KenWillmott/Mini11-M8E/m8.png

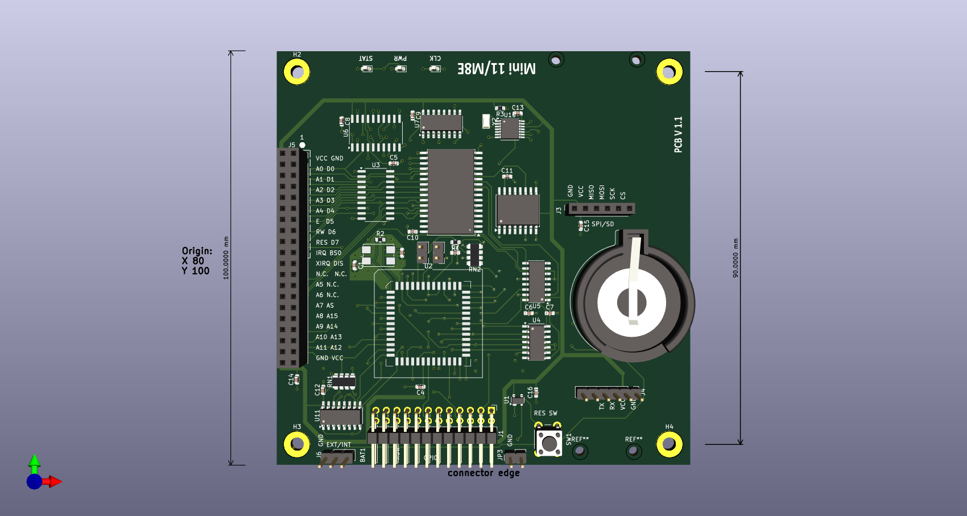
m8.png
