KenWillmott/Mini11-M8E/board.png

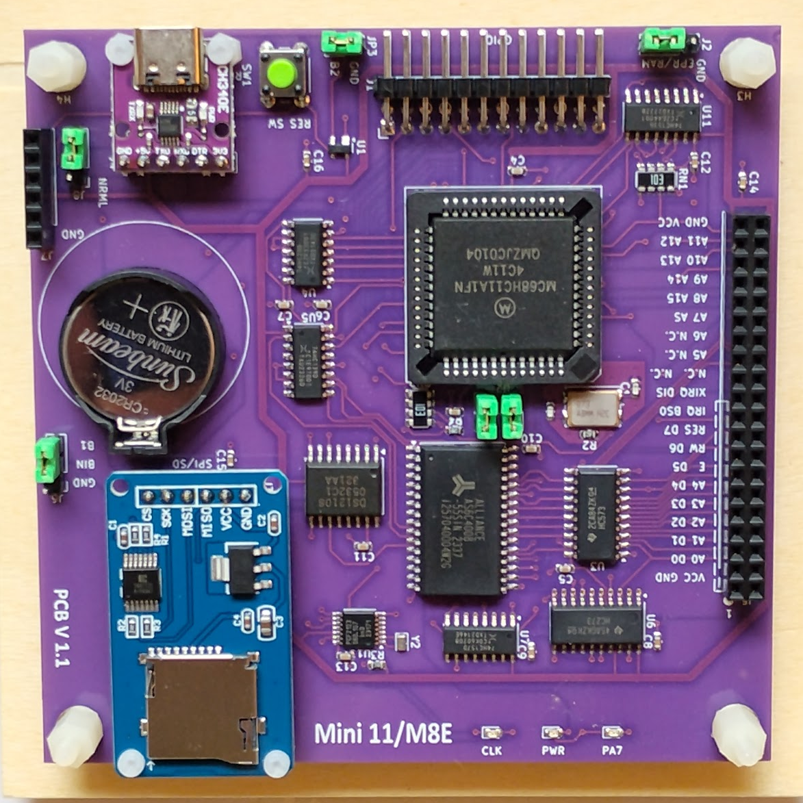
board.png
