KenWillmott/Mini11-M8E/README.md

# Mini11-M8E
MC68HC11A1 MCU based SBC, no ROM
Please read the wiki https://github.com/KenWillmott/Mini11-M8E/wiki
board
