KenWillmott/Mini11-M8E/BOM-T-H27W22492B-2024-09-25.xls

Item # | *Designator | *Qty | Manufacturer | *Mfg Part # | Description / Value | *Package/Footprint | Mounting Type
1 | BT1 | 1 | Keystone |  | CR2032 | Battery:BatteryHolder_Keystone_107_1x23mm | thru-hole
2 | C1,C3 | 2 |  | 0603CG220J500NT | 22p | Capacitor_SMD:C_0603_1608Metric | SMD
3 | C2,C4,C5,C6,C7,C8,C9,C10,C11,C12,C13,C14,C15,C16 | 14 |  | CC0603KRX7R6BB104 | 100n | Capacitor_SMD:C_0603_1608Metric | SMD
4 | D1 | 1 |  | LTST-C191KRKT | STAT | LED_SMD:LED_0603_1608Metric | SMD
5 | D2 | 1 |  | LTST-C191KRKT | PWR | LED_SMD:LED_0603_1608Metric | SMD
6 | D3 | 1 |  | LTST-C191KRKT | CLK | LED_SMD:LED_0603_1608Metric | SMD
7 | H1,H2,H3,H4 | 4 |  |  | MountingHole_Pad | MountingHole:MountingHole_3.2mm_M3_Pad | -
8 | J1 | 1 |  |  | I/O | Connector_PinHeader_2.54mm:PinHeader_2x12_P2.54mm_Horizontal | thru-hole
9 | J2 | 1 |  |  | SBOOT | Connector_PinHeader_2.54mm:PinHeader_1x03_P2.54mm_Vertical | thru-hole
10 | J3 | 1 |  |  | OBSD | Connector_PinHeader_2.54mm:PinHeader_1x06_P2.54mm_Vertical | thru-hole
11 | J4,J7 | 2 |  |  | Serial | -- mixed values -- | thru-hole
12 | J5 | 1 |  |  | Conn_02x20_Odd_Even | Connector_PinSocket_2.54mm:PinSocket_2x20_P2.54mm_Vertical | thru-hole
13 | J6 | 1 |  |  | BAT1 | Connector_PinHeader_2.54mm:PinHeader_1x03_P2.54mm_Vertical | thru-hole
14 | J8 | 1 |  |  | SSEL | Connector_PinHeader_2.54mm:PinHeader_1x03_P2.54mm_Vertical | thru-hole
15 | JP1 | 1 |  |  | MODA | Connector_PinHeader_2.54mm:PinHeader_1x02_P2.54mm_Vertical | thru-hole
16 | JP2 | 1 |  |  | MODB | Connector_PinHeader_2.54mm:PinHeader_1x02_P2.54mm_Vertical | thru-hole
17 | JP3 | 1 |  |  | BAT2 | Connector_PinHeader_2.54mm:PinHeader_1x02_P2.54mm_Vertical | thru-hole
18 | R1 | 1 |  | RC0603FR-071KL | 1.0k | Resistor_SMD:R_0603_1608Metric | SMD
19 | R2 | 1 |  | RC0603FR-0710ML | 10M | Resistor_SMD:R_0603_1608Metric | SMD
20 | R3 | 1 |  | RC0603FR-0710KL | 10k | Resistor_SMD:R_0603_1608Metric | SMD
21 | RN1,RN2 | 2 | Panasonic | YC324-JK-0710KL | R_Pack04 | Resistor_SMD:R_Array_Convex_4x1206 | SMD
22 | SW1 | 1 |  |  | Reset | Button_Switch_THT:SW_PUSH_6mm_H4.3mm | thru-hole
23 | U1 | 1 | Microchip Technology | MIC811LUY-TR | MIC811LUY | Package_TO_SOT_SMD:SOT-143 | SMD
24 | U2 | 1 | 3M | 8452-21B1-RK-TP | 68HC11_PLCC | Package_LCC:PLCC-52_SMD-Socket | SMD
25 | U3 | 1 |  | SN74HC573NSR | 74HC573 | Package_SO:SO-20_5.3x12.6mm_P1.27mm | SMD
26 | U4 | 1 |  | 74HC20D,653 | 74HC20 | Package_SO:SO-14_3.9x8.65mm_P1.27mm | SMD
27 | U5 | 1 |  | 74HC139D,653 | 74HC139 | Package_SO:SO-16_3.9x9.9mm_P1.27mm | SMD
28 | U6 | 1 |  | SN74HC273NSR | 74HC273 | Package_SO:SO-20_5.3x12.6mm_P1.27mm | SMD
29 | U7 | 1 |  | 74HC157D,653 | 74HC157 | Package_SO:SO-16_3.9x9.9mm_P1.27mm | SMD
30 | U8 | 1 |  | AS6C4008-55SIN | AS6C4008 | Package_SO:SSOP-32_11.305x20.495mm_P1.27mm | SMD
31 | U9 | 1 | Maxim, Analog Devices | DS1210S | DS1210S | Package_SO:SOIC-16W_7.5x10.3mm_P1.27mm | SMD
32 | U10 | 1 | NXP | PCF2123TS/1,118 | PCF2123 | Package_SO:TSSOP-14_4.4x5mm_P0.65mm | SMD
33 | U11 | 1 |  | 74HC153D,653 | 74LS153 | Package_SO:SOIC-16_3.9x9.9mm_P1.27mm | SMD
34 | Y1 | 1 | Abracon | ABMM-7.3728MHZ-B2-T | 7.3728 MHz | Crystal:Crystal_SMD_FOX_FQ7050-4Pin_7.0x5.0mm | SMD
35 | Y2 | 1 | Abracon | ABS06-32.768KHZ-T | 32768 kHz | Crystal:Crystal_SMD_2012-2Pin_2.0x1.2mm | SMD
