KenWillmott/Mini11-M8E/m8.pdf

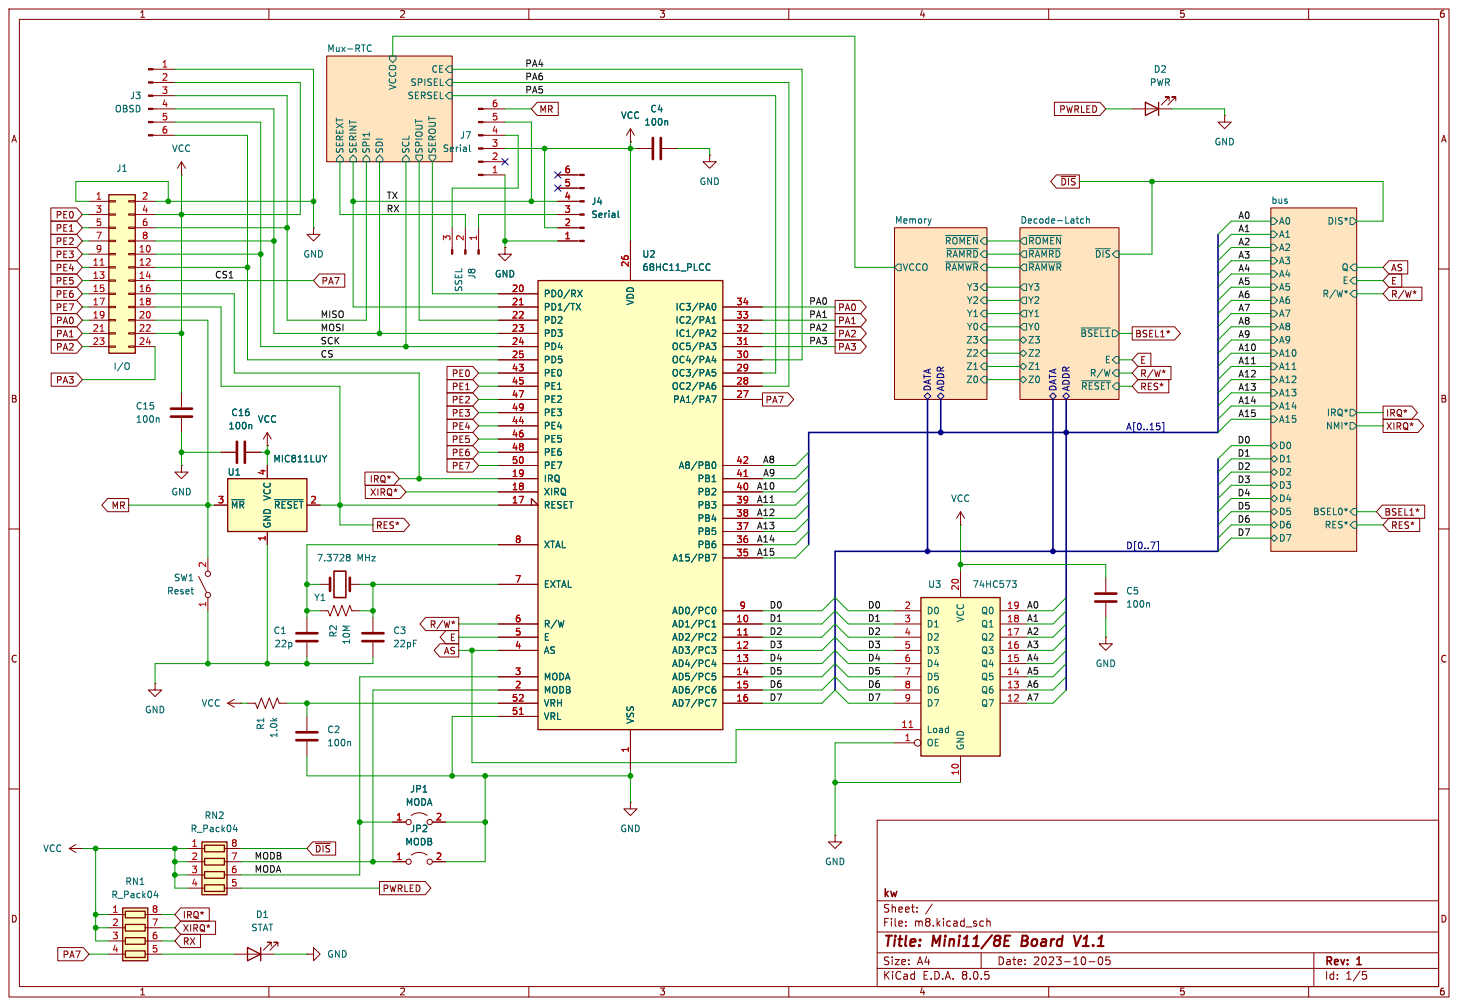
[picture p3: page 1]

IRQ* bus DATA ADDR
Y0Y1Y2 ~{ROMEN}
~{RAMRD}

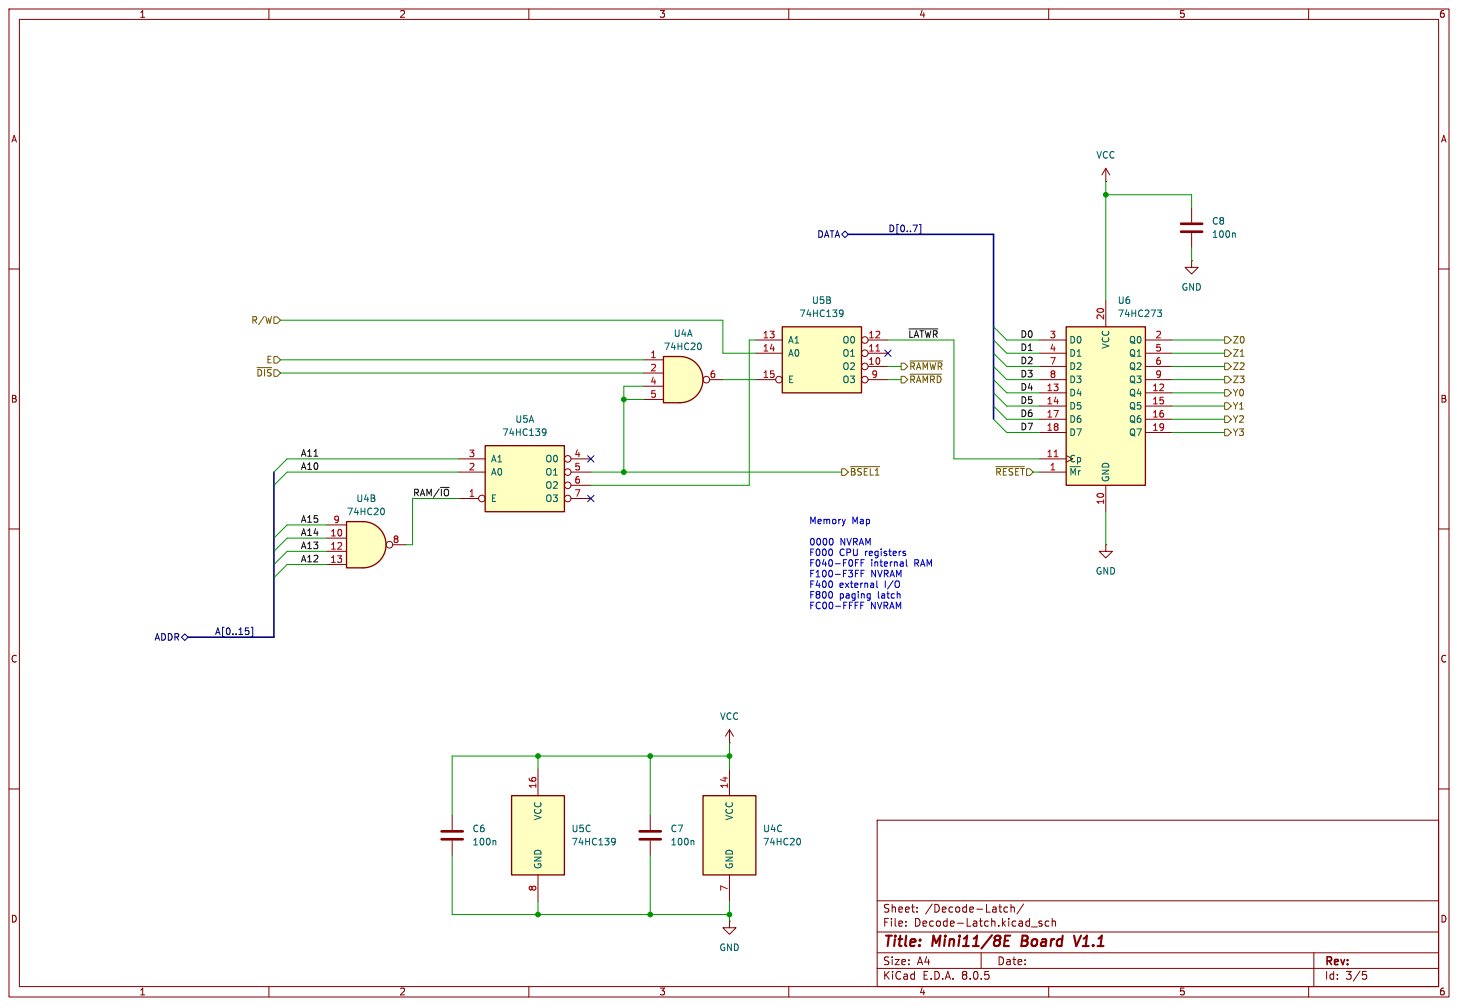
[picture p4: page 2]

File: Decode-Latch.kicad_sch Sheet: /Decode-Latch/

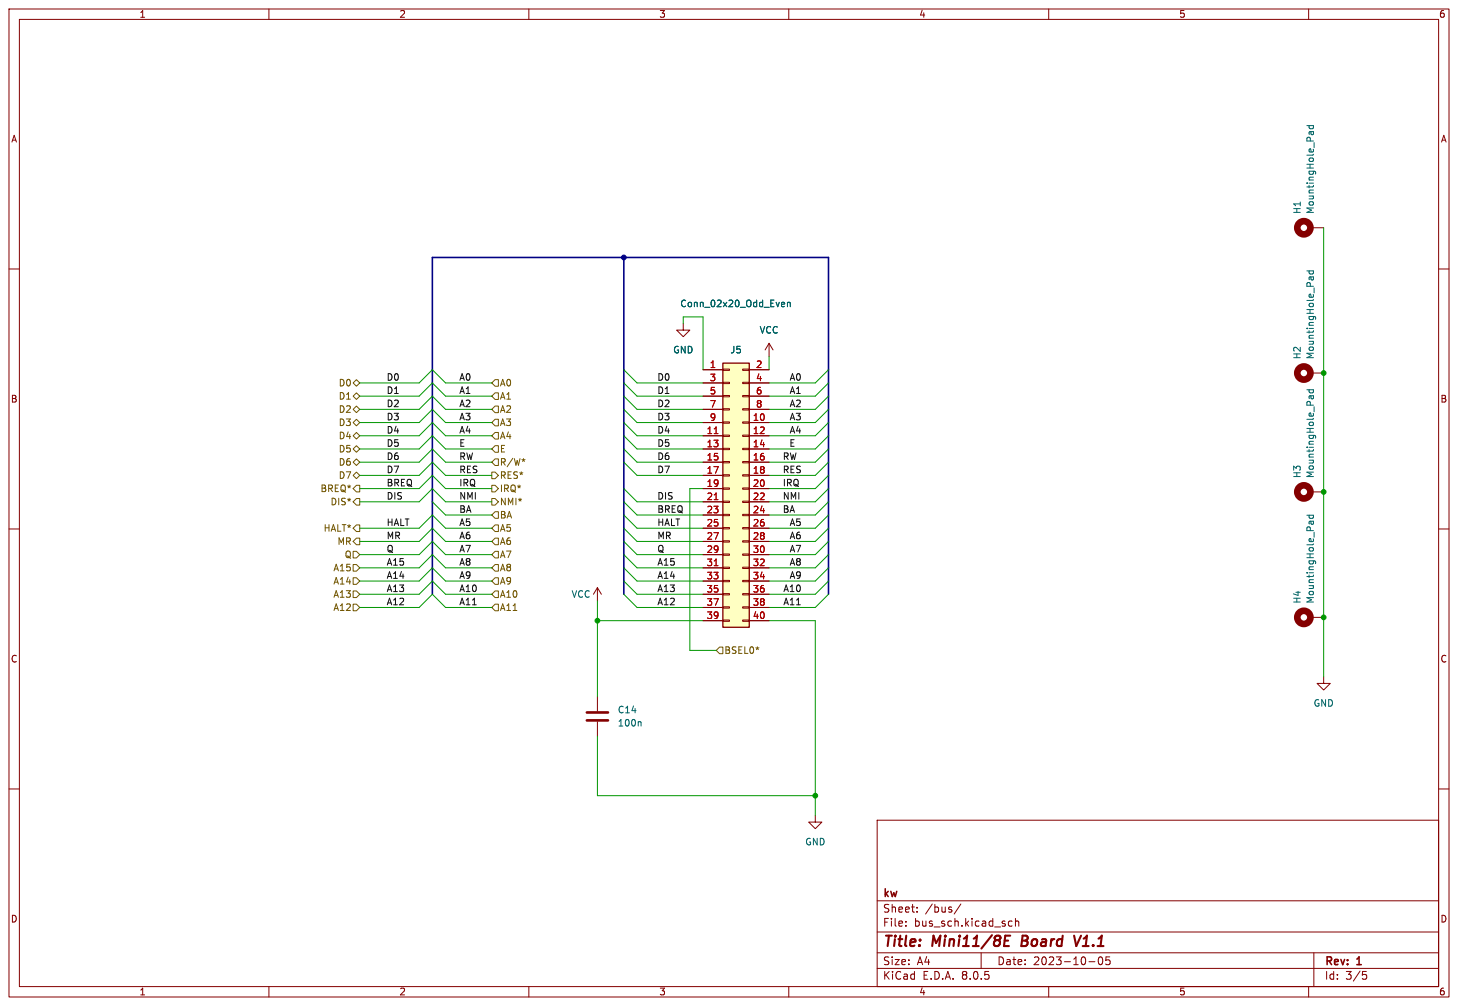
[picture p5: page 3]

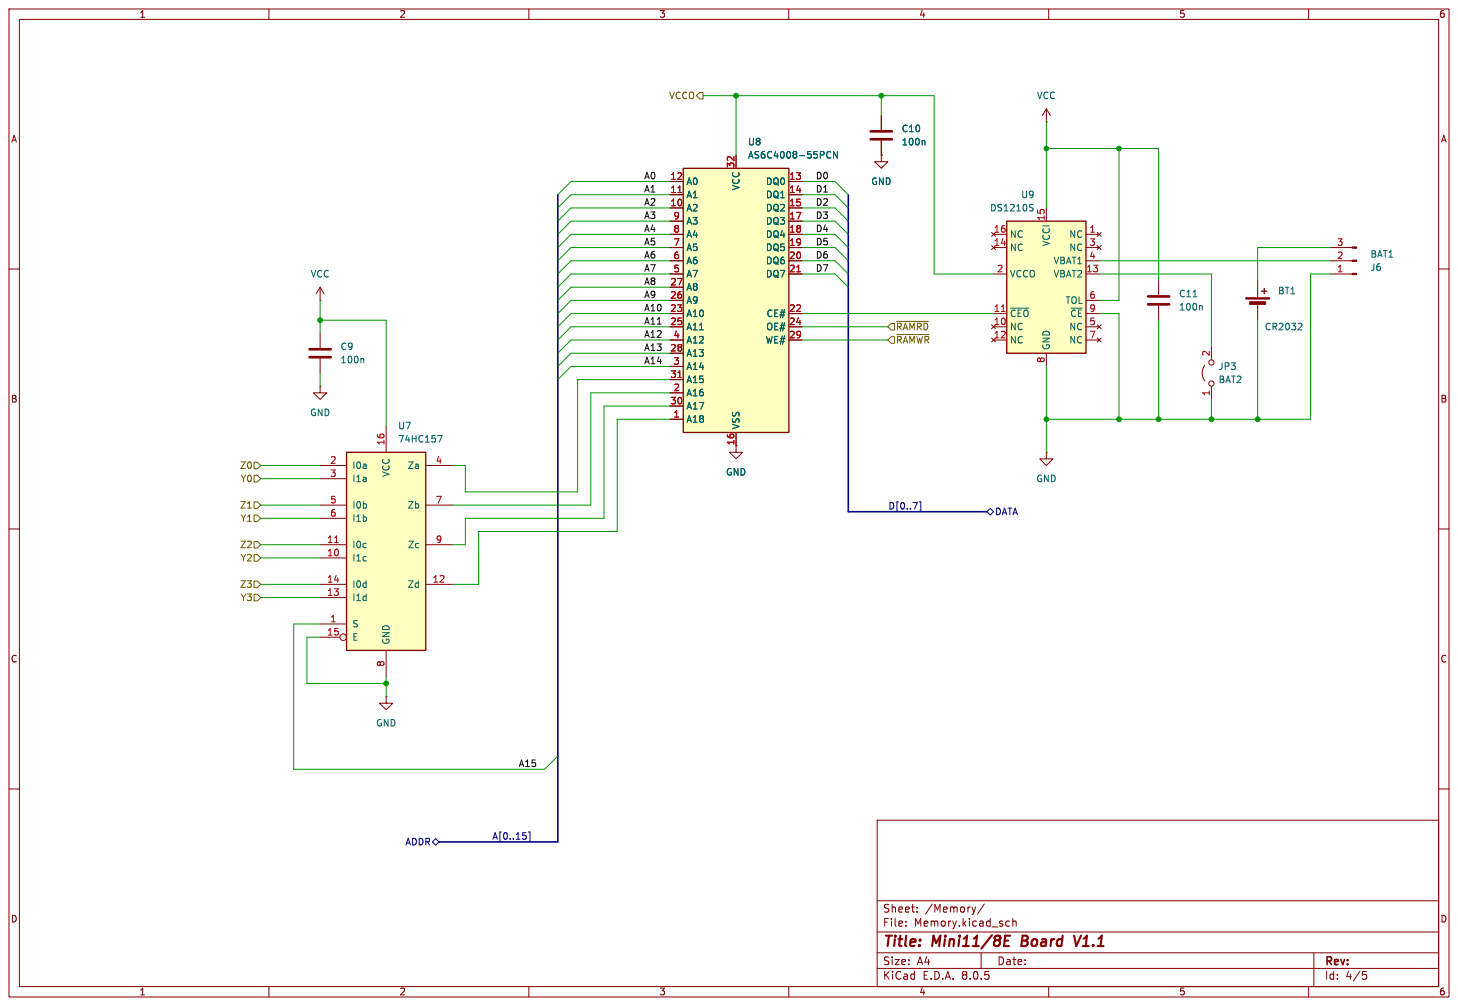
[picture p6: page 4]

File: Memory.kicad_sch Sheet: /Memory/ GND S 1

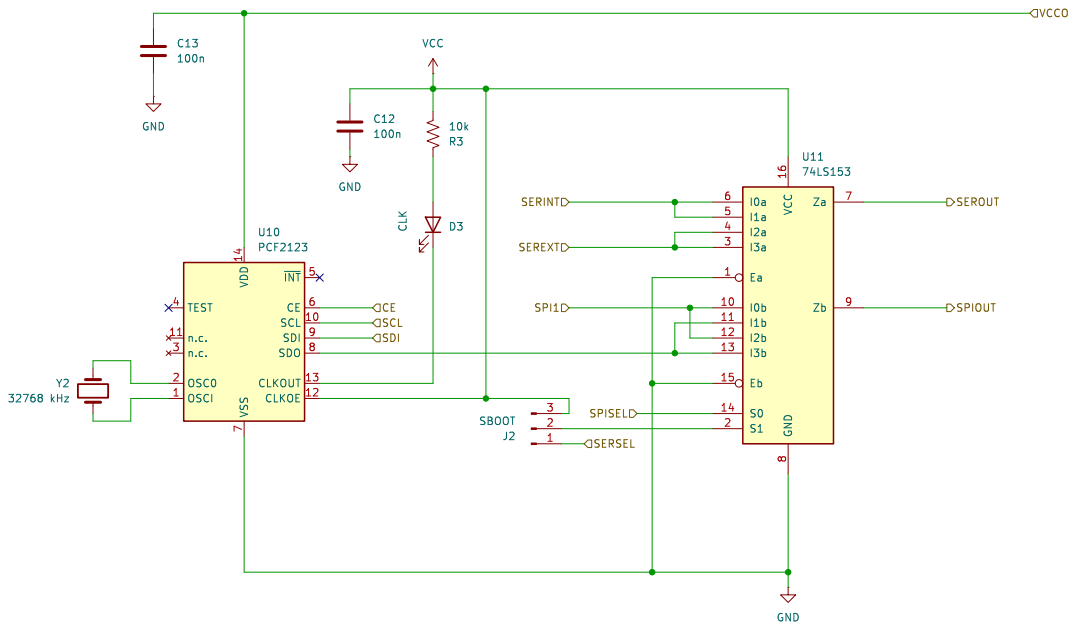
[picture p7: page 5]

File: Mux-RTC_sch.kicad_sch Sheet: /Mux-RTC/
