KenWillmott/Mini11-M8E/m8.kicad_pcb

## KiCad design m8.kicad_pcb (2024-11-02)

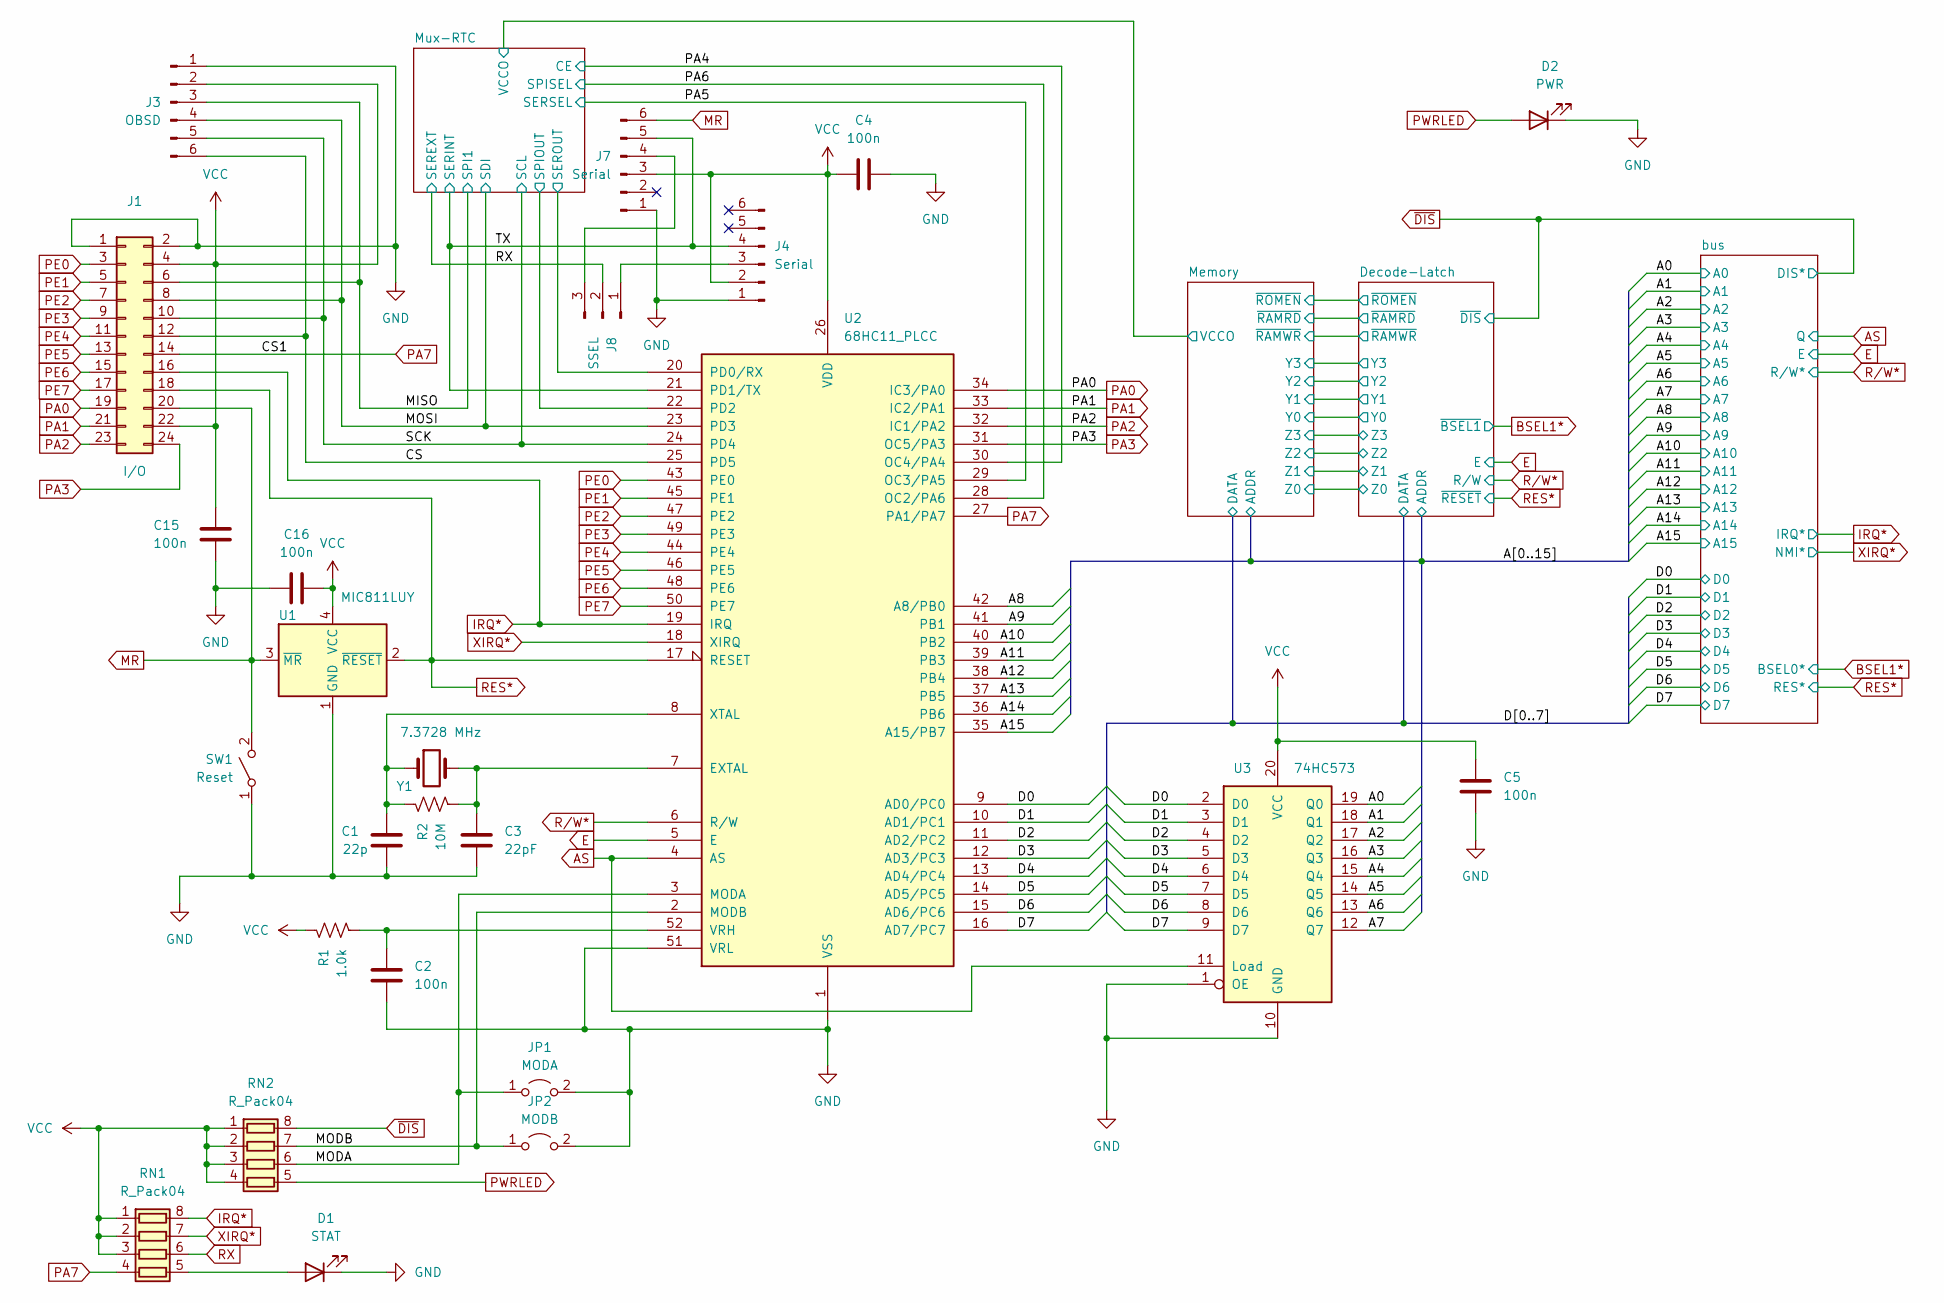
[picture p8: schematic m8.kicad_sch, Mini11/8E Board V1.1]

Parts:
C1: 22p; C_0603_1608Metric
C2, C4, C5, C15, C16: 100n; C_0603_1608Metric
C3: 22pF; C_0603_1608Metric
D1: STAT; LED_0603_1608Metric
D2: PWR; LED_0603_1608Metric
J1: I/O; PinHeader_2x12_P2.54mm_Horizontal
J3: OBSD; PinHeader_1x06_P2.54mm_Vertical
J4: Serial; PinHeader_1x06_P2.54mm_Vertical
J7: Serial; PinSocket_1x06_P2.54mm_Vertical
J8: SSEL; PinHeader_1x03_P2.54mm_Vertical
JP1: MODA; PinHeader_1x02_P2.54mm_Vertical
JP2: MODB; PinHeader_1x02_P2.54mm_Vertical
R1: 1.0k; R_0603_1608Metric
R2: 10M; R_0603_1608Metric
RN1, RN2: R_Pack04; R_Array_Convex_4x1206
SW1: Reset; SW_PUSH_6mm_H4.3mm
U1: MIC811LUY; SOT-143
U2: 68HC11_PLCC; PLCC-52_SMD-Socket
U3: 74HC573; SO-20_12.8x7.5mm_P1.27mm
Y1: 7.3728 MHz; Crystal_SMD_FOX_FQ7050-4Pin_7.0x5.0mm

Connections:
/A0: U3.19 (Q0); also elsewhere on the board
/A1: U3.18 (Q1); also elsewhere on the board
/A2: U3.17 (Q2); also elsewhere on the board
/A3: U3.16 (Q3); also elsewhere on the board
/A4: U3.15 (Q4); also elsewhere on the board
/A5: U3.14 (Q5); also elsewhere on the board
/A6: U3.13 (Q6); also elsewhere on the board
/A7: U3.12 (Q7); also elsewhere on the board
/A8: U2.42 (A8/PB0); also elsewhere on the board
/A9: U2.41 (PB1); also elsewhere on the board
/A10: U2.40 (PB2); also elsewhere on the board
/A11: U2.39 (PB3); also elsewhere on the board
/A12: U2.38 (PB4); also elsewhere on the board
/A13: U2.37 (PB5); also elsewhere on the board
/A14: U2.36 (PB6); also elsewhere on the board
/A15: U2.35 (A15/PB7); also elsewhere on the board
/CS: J1.12, J3.6, U2.25 (PD5)
/D0: U2.9 (AD0/PC0), U3.2 (D0); also elsewhere on the board
/D1: U2.10 (AD1/PC1), U3.3 (D1); also elsewhere on the board
/D2: U2.11 (AD2/PC2), U3.4 (D2); also elsewhere on the board
/D3: U2.12 (AD3/PC3), U3.5 (D3); also elsewhere on the board
/D4: U2.13 (AD4/PC4), U3.6 (D4); also elsewhere on the board
/D5: U2.14 (AD5/PC5), U3.7 (D5); also elsewhere on the board
/D6: U2.15 (AD6/PC6), U3.8 (D6); also elsewhere on the board
/D7: U2.16 (AD7/PC7), U3.9 (D7); also elsewhere on the board
/MISO: J1.6, J3.3; also elsewhere on the board
/MODA: JP1.1 (A), RN2.6 (R3.2), U2.3 (MODA)
/MODB: JP2.1 (A), RN2.7 (R2.2), U2.2 (MODB)
/MOSI: J1.8, J3.4, U2.23 (PD3); also elsewhere on the board
/Mux-RTC/SEROUT: U2.20 (PD0/RX); also elsewhere on the board
/Mux-RTC/SPIOUT: U2.22 (PD2); also elsewhere on the board
/PA4: U2.30 (OC4/PA4); also elsewhere on the board
/PA5: U2.29 (OC3/PA5); also elsewhere on the board
/PA6: U2.28 (OC2/PA6); also elsewhere on the board
/SCK: J1.10, J3.5, U2.24 (PD4); also elsewhere on the board
/TX: J4.4, J7.5, U2.21 (PD1/TX); also elsewhere on the board
AS: U2.4 (AS), U3.11 (Load); also elsewhere on the board
E: U2.5 (E); also elsewhere on the board
GND: C1.2, C2.2, C3.2, C4.2, C5.2, C15.2, C16.1, D1.1 (K), D2.1 (K), J1.1, J1.2, J3.1, J4.1, J7.1, JP1.2 (B), JP2.2 (B), SW1.1 (A), U1.1 (GND), U2.1 (VSS), U2.51 (VRL), U3.1 (OE), U3.10 (GND); also elsewhere on the board
IRQ*: J1.16, RN1.8 (R1.2), U2.19 (IRQ); also elsewhere on the board
MR: J1.20, J7.6, SW1.2 (B), U1.3 (~MR)
unnamed: D1.2 (A), RN1.5 (R4.2)
unnamed: J4.3, J8.1
unnamed: J7.4, J8.3
unnamed: C3.1, R2.2, U2.7 (EXTAL), Y1.3
unnamed: C2.1, R1.2, U2.52 (VRH)
unnamed: C1.1, R2.1, U2.8 (XTAL), Y1.1
PA0: J1.19, U2.34 (IC3/PA0)
PA1: J1.21, U2.33 (IC2/PA1)
PA2: J1.23, U2.32 (IC1/PA2)
PA3: J1.24, U2.31 (OC5/PA3)
PA7: J1.14, RN1.4 (R4.1), U2.27 (PA1/PA7)
PE0: J1.3, U2.43 (PE0)
PE1: J1.5, U2.45 (PE1)
PE2: J1.7, U2.47 (PE2)
PE3: J1.9, U2.49 (PE3)
PE4: J1.11, U2.44 (PE4)
PE5: J1.13, U2.46 (PE5)
PE6: J1.15, U2.48 (PE6)
PE7: J1.17, U2.50 (PE7)
PWRLED: D2.2 (A), RN2.5 (R4.2)
RES*: J1.18, U1.2 (~RESET), U2.17 (RESET); also elsewhere on the board
RX: J8.2, RN1.6 (R3.2); also elsewhere on the board
R/W*: U2.6 (R/W); also elsewhere on the board
VCC: C4.1, C5.1, C15.1, C16.2, J1.4, J1.22, J3.2, J4.2, J7.3, R1.1, RN1.1 (R1.1), RN1.2 (R2.1), RN1.3 (R3.1), RN2.1 (R1.1), RN2.2 (R2.1), RN2.3 (R3.1), RN2.4 (R4.1), U1.4 (VCC), U2.26 (VDD), U3.20 (VCC); also elsewhere on the board
XIRQ*: RN1.7 (R2.2), U2.18 (XIRQ); also elsewhere on the board
~DIS: RN2.8 (R1.2); also elsewhere on the board

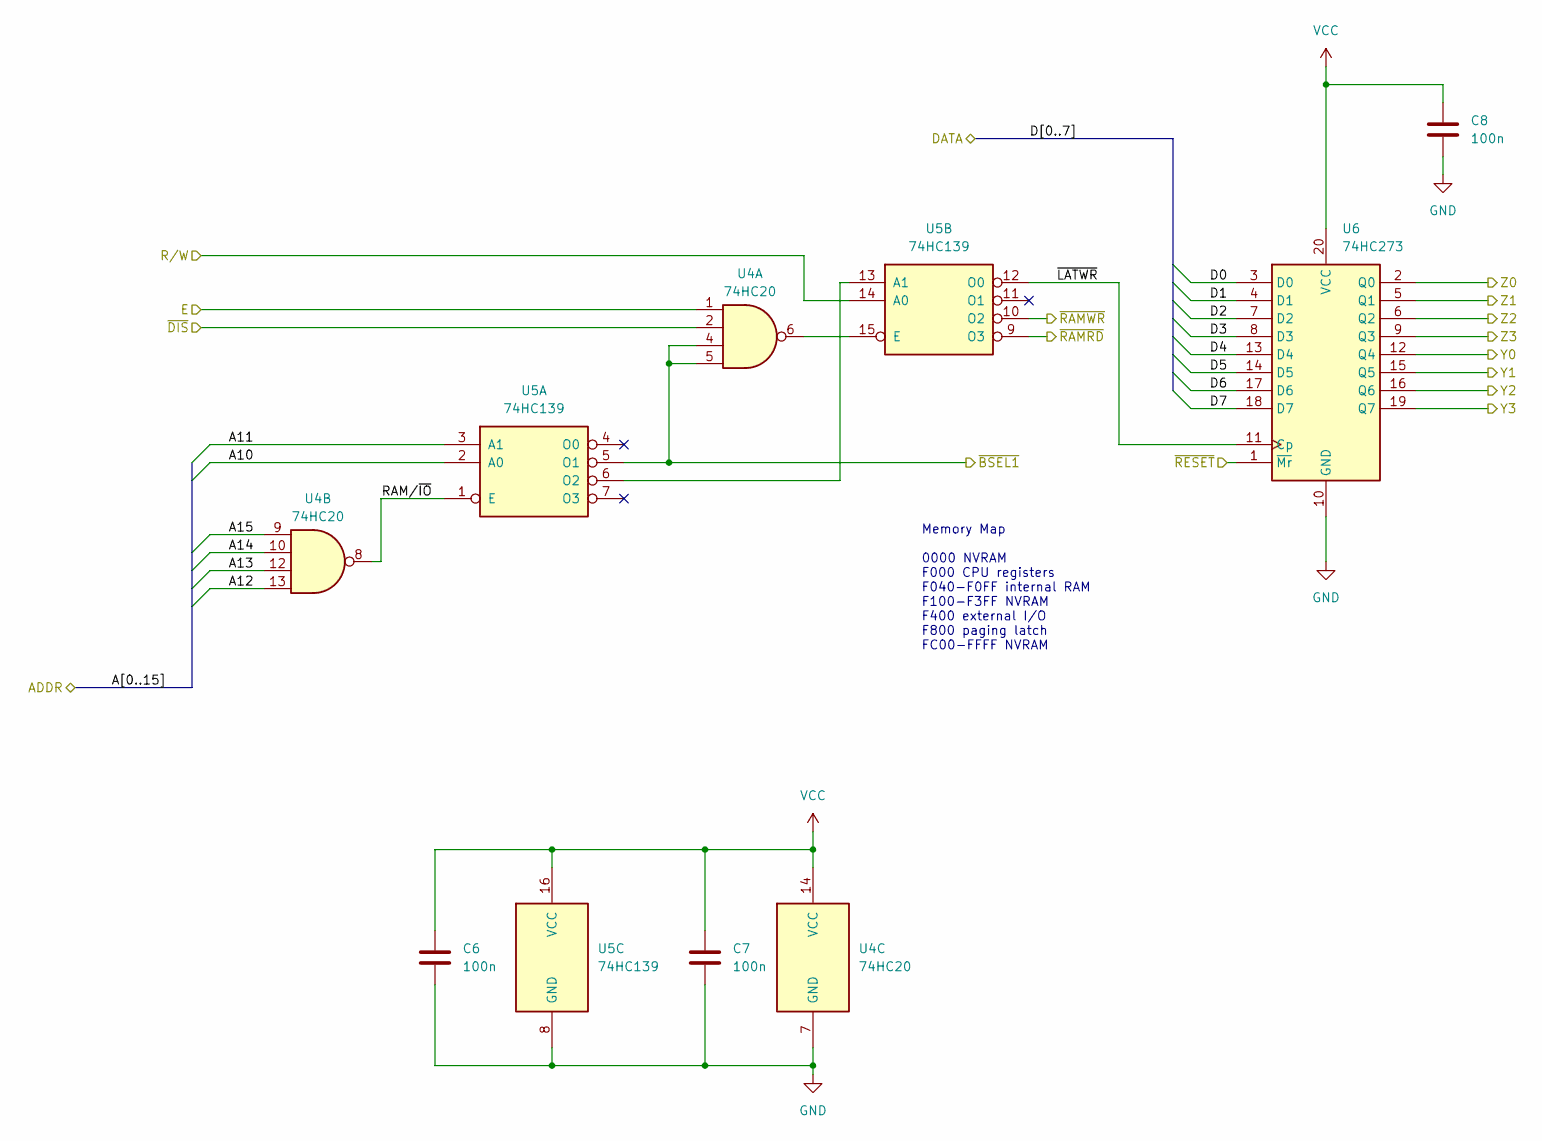
[picture p9: schematic Decode-Latch.kicad_sch, Mini11/8E Board V1.1]

Parts:
C6, C7, C8: 100n; C_0603_1608Metric
U4: 74HC20; SO-14_3.9x8.65mm_P1.27mm
U5: 74HC139; SO-16_3.9x9.9mm_P1.27mm
U6: 74HC273; SOP-20_7.5x12.8mm_P1.27mm

Connections:
/A10: U5.2 (A0); also elsewhere on the board
/A11: U5.3 (A1); also elsewhere on the board
/A12: U4.13; also elsewhere on the board
/A13: U4.12; also elsewhere on the board
/A14: U4.10; also elsewhere on the board
/A15: U4.9; also elsewhere on the board
/D0: U6.3 (D0); also elsewhere on the board
/D1: U6.4 (D1); also elsewhere on the board
/D2: U6.7 (D2); also elsewhere on the board
/D3: U6.8 (D3); also elsewhere on the board
/D4: U6.13 (D4); also elsewhere on the board
/D5: U6.14 (D5); also elsewhere on the board
/D6: U6.17 (D6); also elsewhere on the board
/D7: U6.18 (D7); also elsewhere on the board
/Decode-Latch/RAM/~IO: U4.8, U5.1 (E)
/Decode-Latch/Y0: U6.12 (Q4); also elsewhere on the board
/Decode-Latch/Y1: U6.15 (Q5); also elsewhere on the board
/Decode-Latch/Y2: U6.16 (Q6); also elsewhere on the board
/Decode-Latch/Y3: U6.19 (Q7); also elsewhere on the board
/Decode-Latch/Z0: U6.2 (Q0); also elsewhere on the board
/Decode-Latch/Z1: U6.5 (Q1); also elsewhere on the board
/Decode-Latch/Z2: U6.6 (Q2); also elsewhere on the board
/Decode-Latch/Z3: U6.9 (Q3); also elsewhere on the board
/Decode-Latch/~LATWR: U5.12 (O0), U6.11 (Cp)
/Decode-Latch/~RAMRD: U5.9 (O3); also elsewhere on the board
/Decode-Latch/~RAMWR: U5.10 (O2); also elsewhere on the board
BSEL1*: U4.4, U4.5, U5.5 (O1); also elsewhere on the board
E: U4.1; also elsewhere on the board
GND: C6.2, C7.2, C8.2, U4.7 (GND), U5.8 (GND), U6.10 (GND); also elsewhere on the board
unnamed: U5.6 (O2), U5.13 (A1)
unnamed: U4.6, U5.15 (E)
RES*: U6.1 (~Mr); also elsewhere on the board
R/W*: U5.14 (A0); also elsewhere on the board
VCC: C6.1, C7.1, C8.1, U4.14 (VCC), U5.16 (VCC), U6.20 (VCC); also elsewhere on the board
~DIS: U4.2; also elsewhere on the board

Notes on the sheet:
Memory Map 0000 NVRAM F000 CPU registers F040-F0FF internal RAM F100-F3FF NVRAM F400 external I/O F800 paging latch FC00-FFFF NVRAM

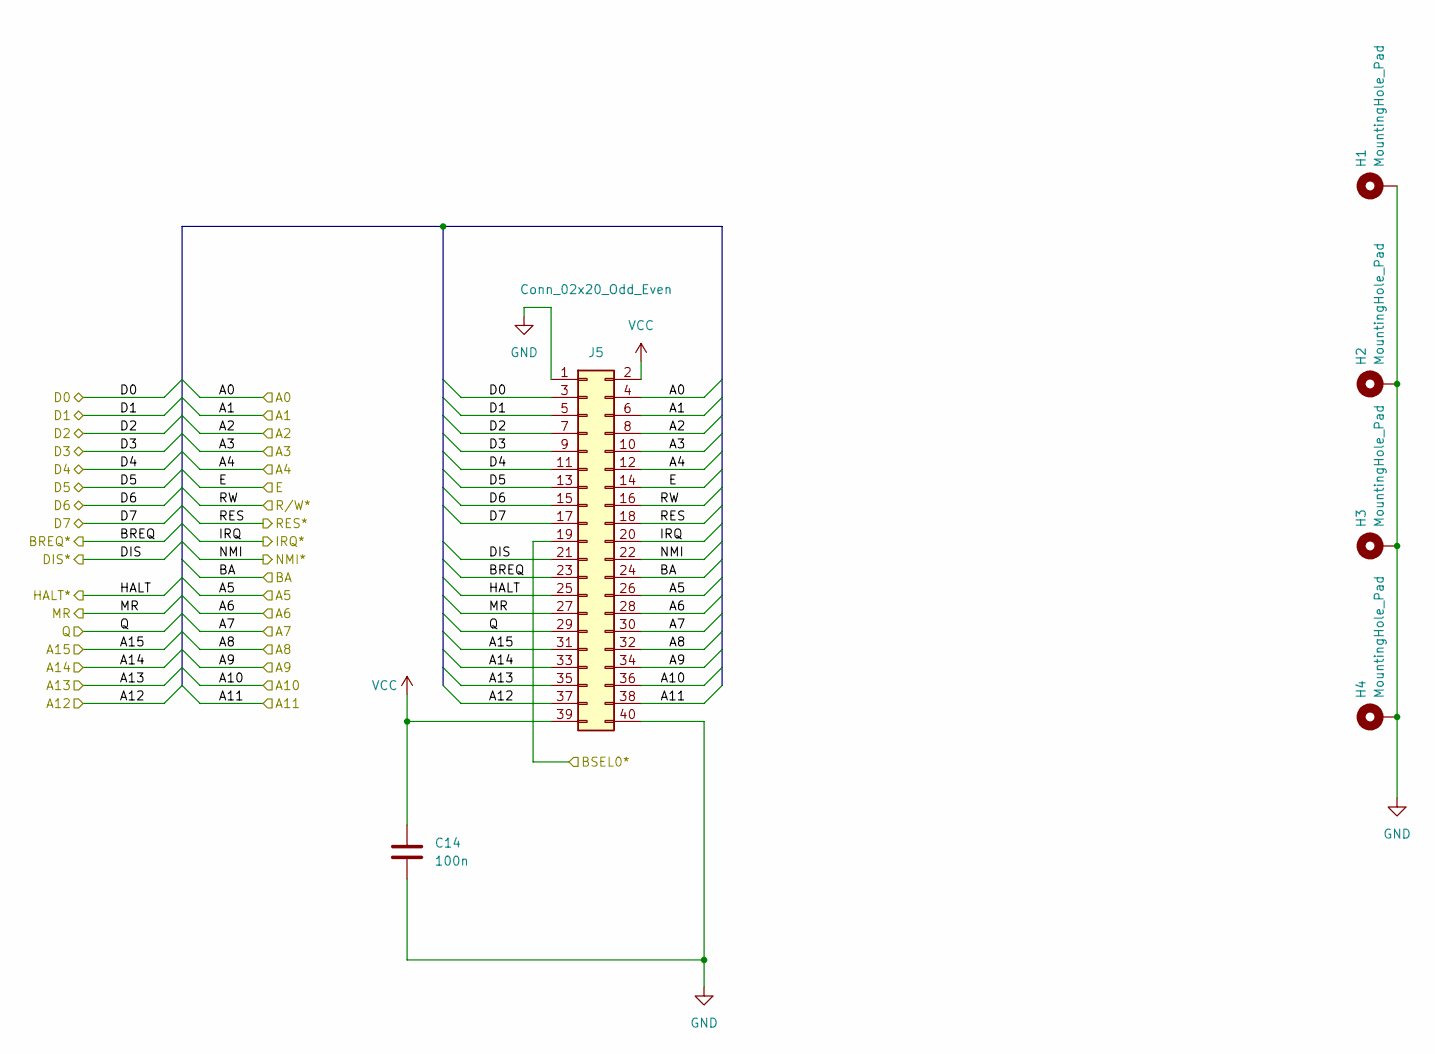
[picture p10: schematic bus_sch.kicad_sch, Mini11/8E Board V1.1]

Parts:
C14: 100n; C_0603_1608Metric
H1, H2, H3, H4: MountingHole_Pad; MountingHole_3.2mm_M3_Pad
J5: Conn_02x20_Odd_Even; PinSocket_2x20_P2.54mm_Vertical

Connections:
/A0: J5.4; also elsewhere on the board
/A1: J5.6; also elsewhere on the board
/A2: J5.8; also elsewhere on the board
/A3: J5.10; also elsewhere on the board
/A4: J5.12; also elsewhere on the board
/A5: J5.26; also elsewhere on the board
/A6: J5.28; also elsewhere on the board
/A7: J5.30; also elsewhere on the board
/A8: J5.32; also elsewhere on the board
/A9: J5.34; also elsewhere on the board
/A10: J5.36; also elsewhere on the board
/A11: J5.38; also elsewhere on the board
/A12: J5.37; also elsewhere on the board
/A13: J5.35; also elsewhere on the board
/A14: J5.33; also elsewhere on the board
/A15: J5.31; also elsewhere on the board
/D0: J5.3; also elsewhere on the board
/D1: J5.5; also elsewhere on the board
/D2: J5.7; also elsewhere on the board
/D3: J5.9; also elsewhere on the board
/D4: J5.11; also elsewhere on the board
/D5: J5.13; also elsewhere on the board
/D6: J5.15; also elsewhere on the board
/D7: J5.17; also elsewhere on the board
/bus/BA: J5.24
/bus/BREQ: J5.23
/bus/HALT: J5.25
/bus/MR: J5.27
AS: J5.29; also elsewhere on the board
BSEL1*: J5.19; also elsewhere on the board
E: J5.14; also elsewhere on the board
GND: C14.1, H1.1, H2.1, H3.1, H4.1, J5.1, J5.40; also elsewhere on the board
IRQ*: J5.20; also elsewhere on the board
RES*: J5.18; also elsewhere on the board
R/W*: J5.16; also elsewhere on the board
VCC: C14.2, J5.2, J5.39; also elsewhere on the board
XIRQ*: J5.22; also elsewhere on the board
~DIS: J5.21; also elsewhere on the board

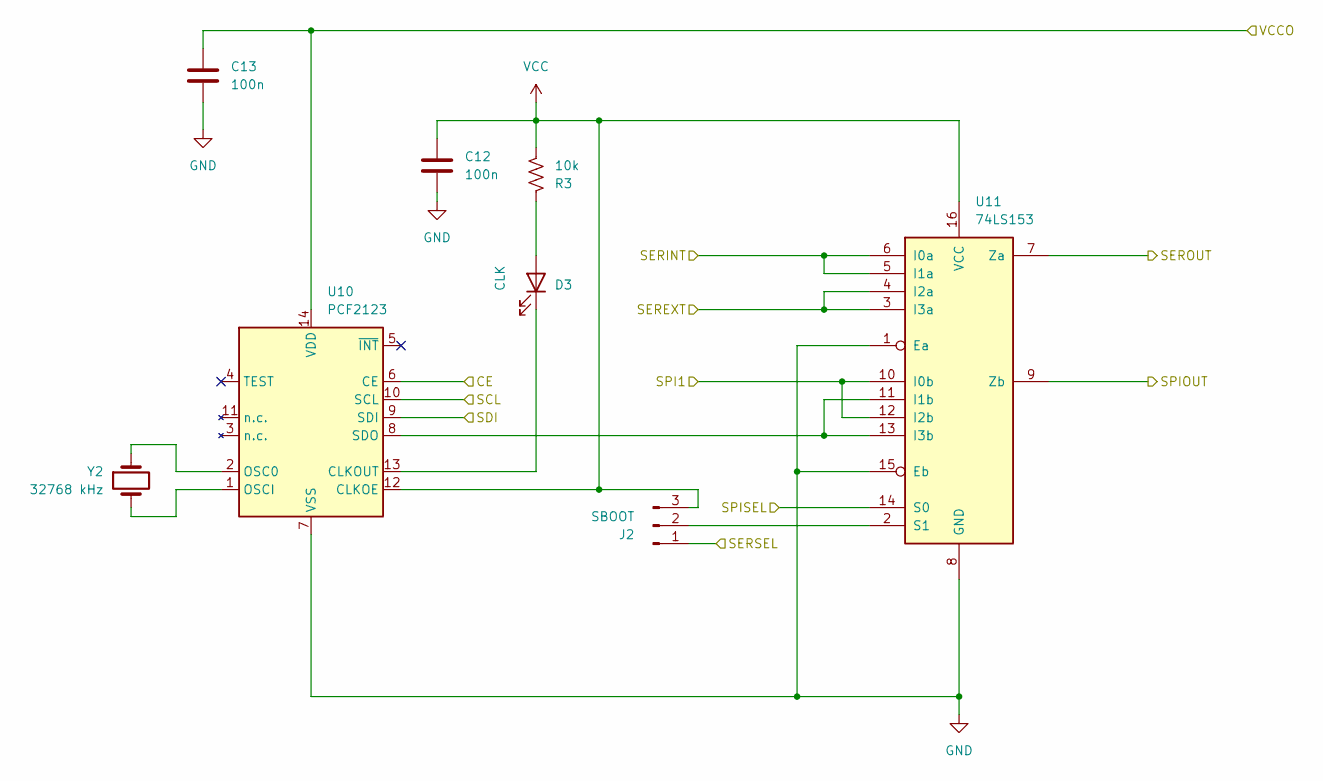
[picture p11: schematic Mux-RTC_sch.kicad_sch, Mini11/8E Board V1.1]

Parts:
C12, C13: 100n; C_0603_1608Metric
D3: CLK; LED_0603_1608Metric
J2: SBOOT; PinHeader_1x03_P2.54mm_Vertical
R3: 10k; R_0603_1608Metric
U10: PCF2123; TSSOP-14_4.4x5mm_P0.65mm
U11: 74LS153; SOIC-16_3.9x9.9mm_P1.27mm
Y2: 32768 kHz; Crystal_SMD_2012-2Pin_2.0x1.2mm

Connections:
/MISO: U11.10 (I0b), U11.12 (I2b); also elsewhere on the board
/MOSI: U10.9 (SDI); also elsewhere on the board
/Memory/VCCO: C13.2, U10.14 (VDD); also elsewhere on the board
/Mux-RTC/SEROUT: U11.7 (Za); also elsewhere on the board
/Mux-RTC/SPIOUT: U11.9 (Zb); also elsewhere on the board
/PA4: U10.6 (CE); also elsewhere on the board
/PA5: J2.1; also elsewhere on the board
/PA6: U11.14 (S0); also elsewhere on the board
/SCK: U10.10 (SCL); also elsewhere on the board
/TX: U11.5 (I1a), U11.6 (I0a); also elsewhere on the board
GND: C12.2, C13.1, U10.7 (VSS), U11.1 (Ea), U11.8 (GND), U11.15 (Eb); also elsewhere on the board
unnamed: D3.2 (A), R3.1
unnamed: D3.1 (K), U10.13 (CLKOUT)
unnamed: J2.2, U11.2 (S1)
unnamed: U10.2 (OSC0), Y2.1
unnamed: U10.1 (OSCI), Y2.2
unnamed: U10.8 (SDO), U11.11 (I1b), U11.13 (I3b)
RX: U11.3 (I3a), U11.4 (I2a); also elsewhere on the board
VCC: C12.1, J2.3, R3.2, U10.12 (CLKOE), U11.16 (VCC); also elsewhere on the board

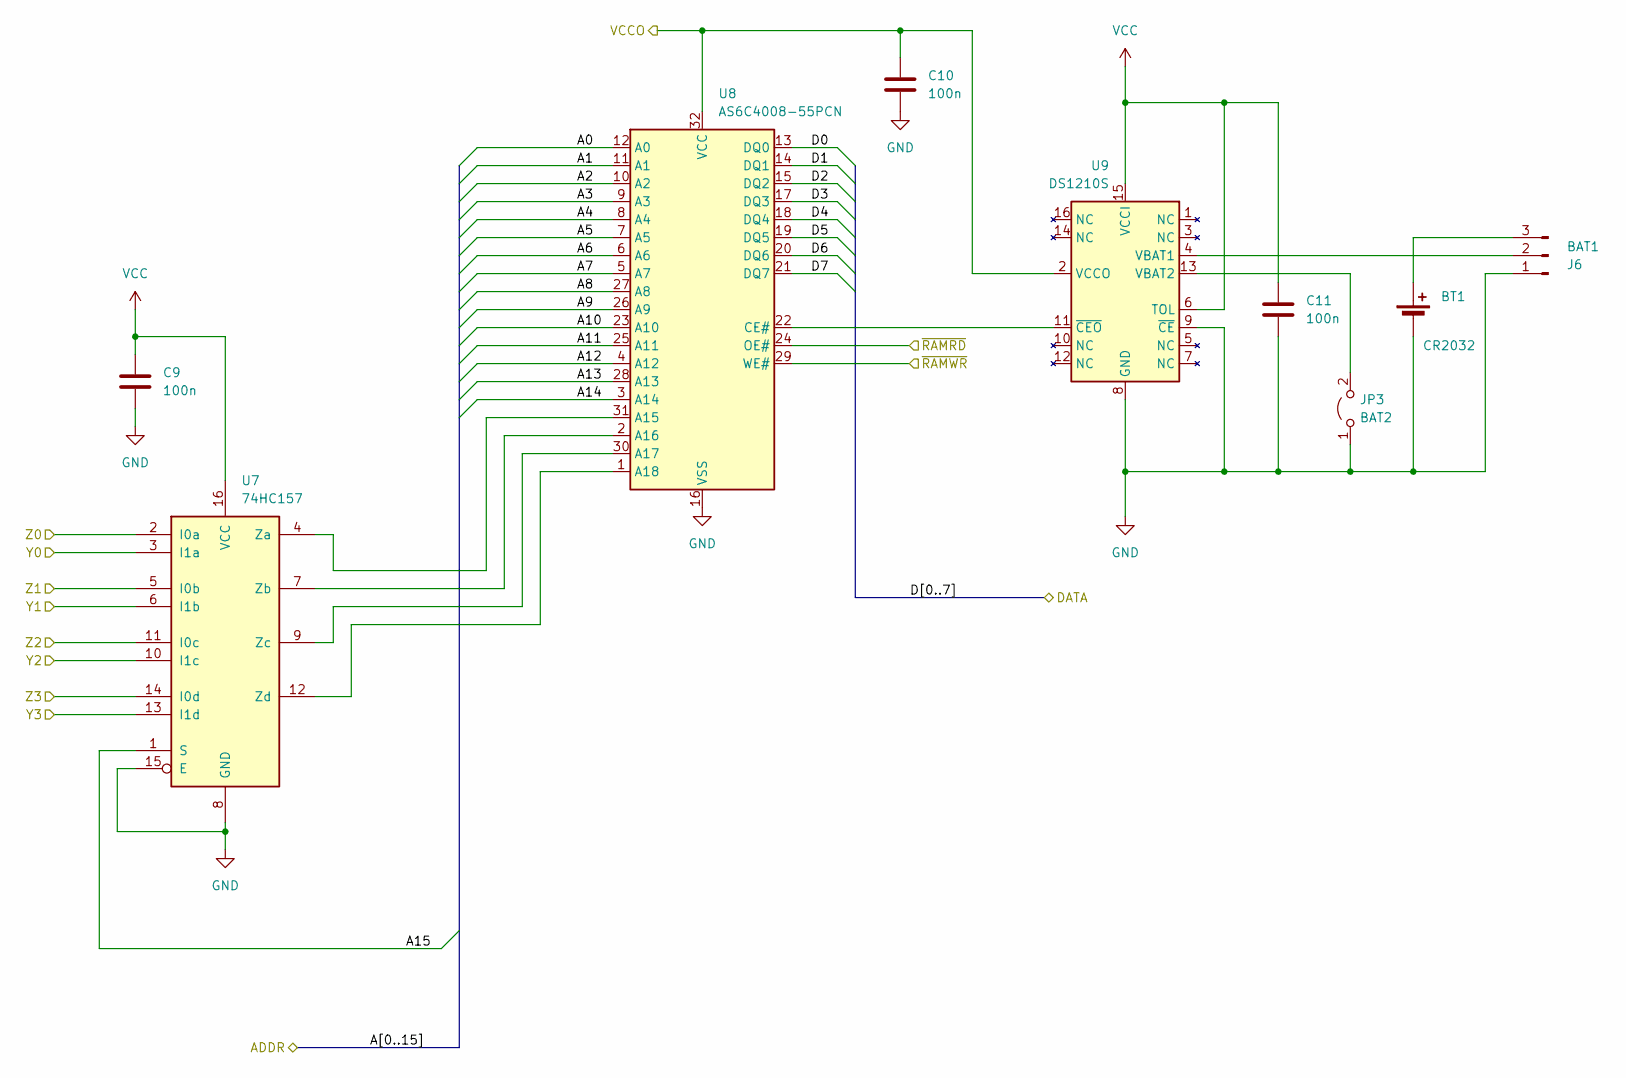
[picture p12: schematic Memory.kicad_sch, Mini11/8E Board V1.1]

Parts:
BT1: CR2032; BatteryHolder_Keystone_107_1x23mm
C9, C10, C11: 100n; C_0603_1608Metric
J6: BAT1; PinHeader_1x03_P2.54mm_Vertical
JP3: BAT2; PinHeader_1x02_P2.54mm_Vertical
U7: 74HC157; SO-16_3.9x9.9mm_P1.27mm
U8: AS6C4008-55PCN; SSOP-32_11.305x20.495mm_P1.27mm
U9: DS1210S; SOIC-16W_7.5x10.3mm_P1.27mm

Connections:
/A0: U8.12 (A0); also elsewhere on the board
/A1: U8.11 (A1); also elsewhere on the board
/A2: U8.10 (A2); also elsewhere on the board
/A3: U8.9 (A3); also elsewhere on the board
/A4: U8.8 (A4); also elsewhere on the board
/A5: U8.7 (A5); also elsewhere on the board
/A6: U8.6 (A6); also elsewhere on the board
/A7: U8.5 (A7); also elsewhere on the board
/A8: U8.27 (A8); also elsewhere on the board
/A9: U8.26 (A9); also elsewhere on the board
/A10: U8.23 (A10); also elsewhere on the board
/A11: U8.25 (A11); also elsewhere on the board
/A12: U8.4 (A12); also elsewhere on the board
/A13: U8.28 (A13); also elsewhere on the board
/A14: U8.3 (A14); also elsewhere on the board
/A15: U7.1 (S); also elsewhere on the board
/D0: U8.13 (DQ0); also elsewhere on the board
/D1: U8.14 (DQ1); also elsewhere on the board
/D2: U8.15 (DQ2); also elsewhere on the board
/D3: U8.17 (DQ3); also elsewhere on the board
/D4: U8.18 (DQ4); also elsewhere on the board
/D5: U8.19 (DQ5); also elsewhere on the board
/D6: U8.20 (DQ6); also elsewhere on the board
/D7: U8.21 (DQ7); also elsewhere on the board
/Decode-Latch/Y0: U7.3 (I1a); also elsewhere on the board
/Decode-Latch/Y1: U7.6 (I1b); also elsewhere on the board
/Decode-Latch/Y2: U7.10 (I1c); also elsewhere on the board
/Decode-Latch/Y3: U7.13 (I1d); also elsewhere on the board
/Decode-Latch/Z0: U7.2 (I0a); also elsewhere on the board
/Decode-Latch/Z1: U7.5 (I0b); also elsewhere on the board
/Decode-Latch/Z2: U7.11 (I0c); also elsewhere on the board
/Decode-Latch/Z3: U7.14 (I0d); also elsewhere on the board
/Decode-Latch/~RAMRD: U8.24 (OE#); also elsewhere on the board
/Decode-Latch/~RAMWR: U8.29 (WE#); also elsewhere on the board
/Memory/VCCO: C10.1, U8.32 (VCC), U9.2 (VCCO); also elsewhere on the board
GND: BT1.2 (-), C9.2, C10.2, C11.2, J6.1, JP3.1 (A), U7.8 (GND), U7.15 (E), U8.16 (VSS), U9.8 (GND), U9.9 (~CE); also elsewhere on the board
unnamed: BT1.1 (+), J6.3
unnamed: J6.2, U9.4 (VBAT1)
unnamed: JP3.2 (B), U9.13 (VBAT2)
unnamed: U7.4 (Za), U8.31 (A15)
unnamed: U7.7 (Zb), U8.2 (A16)
unnamed: U7.9 (Zc), U8.30 (A17)
unnamed: U7.12 (Zd), U8.1 (A18)
unnamed: U8.22 (CE#), U9.11 (~CEO)
VCC: C9.1, C11.1, U7.16 (VCC), U9.6 (TOL), U9.15 (VCCI); also elsewhere on the board

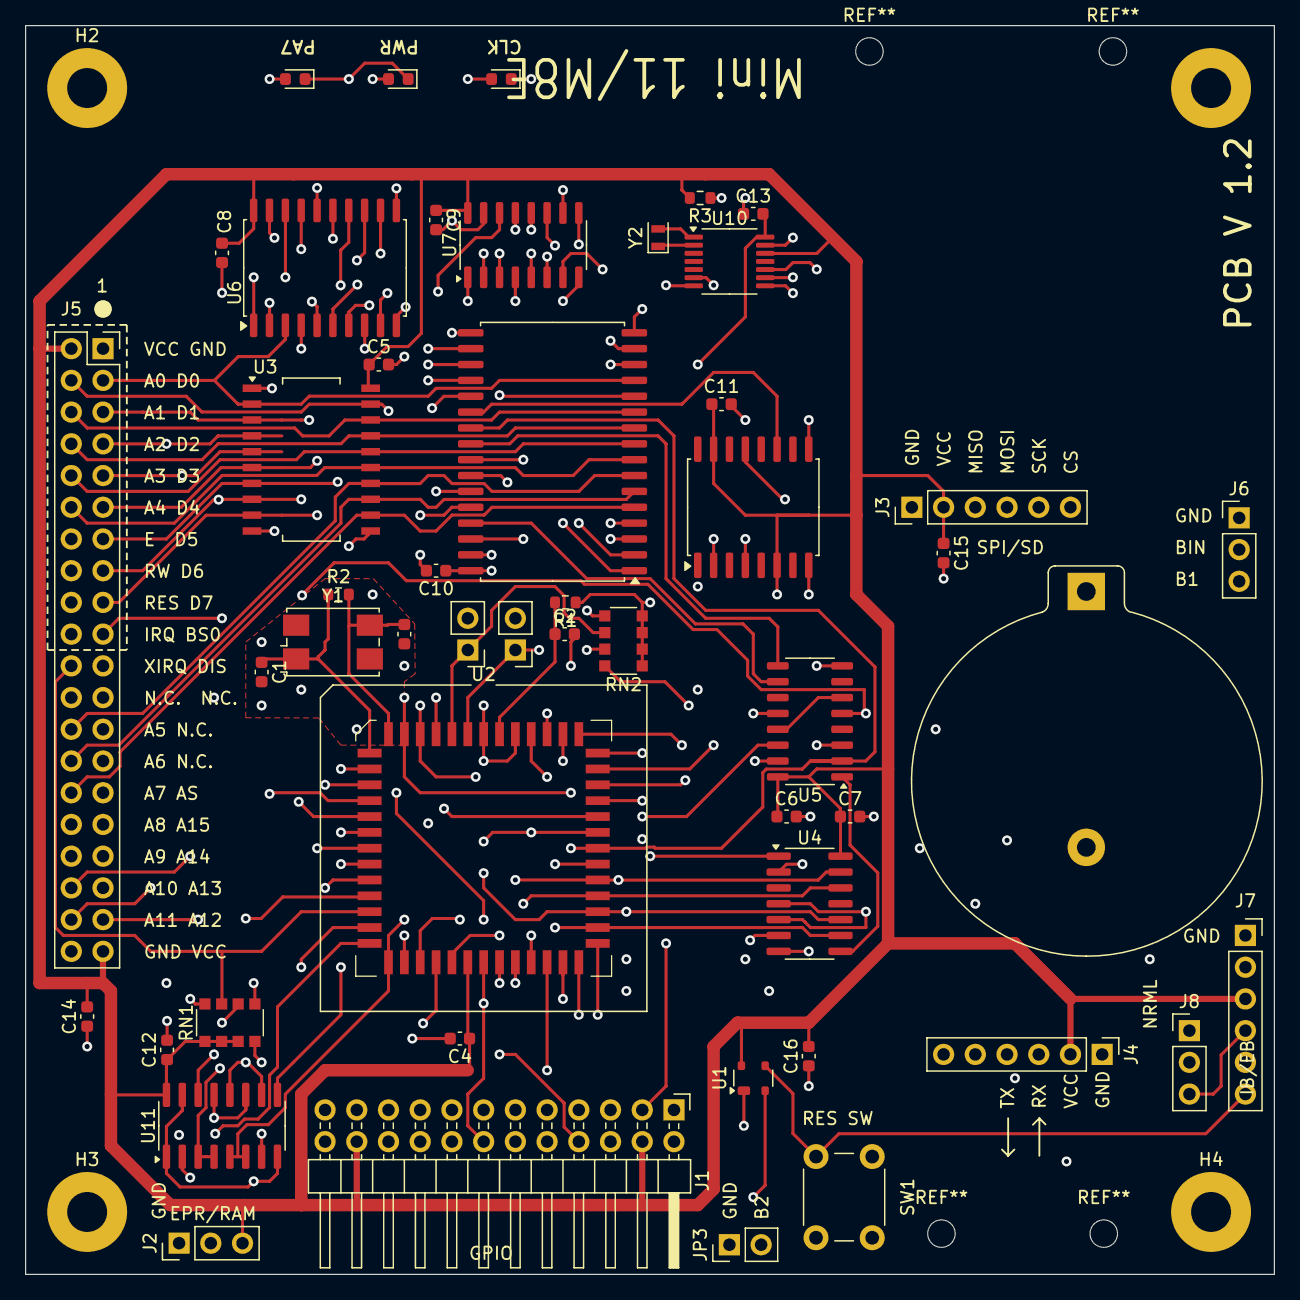
[picture p13: board m8.kicad_pcb from above]

Board: 4 copper layers, 100.0 x 100.0 mm, 54 parts (0 on the bottom side), 97 nets.
