KenWillmott/Mini11-M8E/(commit log)

2024-10-31 Bill of Materials
    [BOM-T-H27W22492B-2024-09-25.xls]
2024-11-01 completed board image
